Makehare/bell-aid/README.md

# bell-aid

Bell Aid

Release v1.3.1.

## Contents

- `docs/`
- `electronics/`
- `firmware/`
- `mechanics/`

## License

Hardware CERN-OHL-P-2.0, firmware MIT, documentation and renders CC-BY-4.0 (see LICENSE).
