Makehare/bell-aid/docs/renders/final/03-front.png

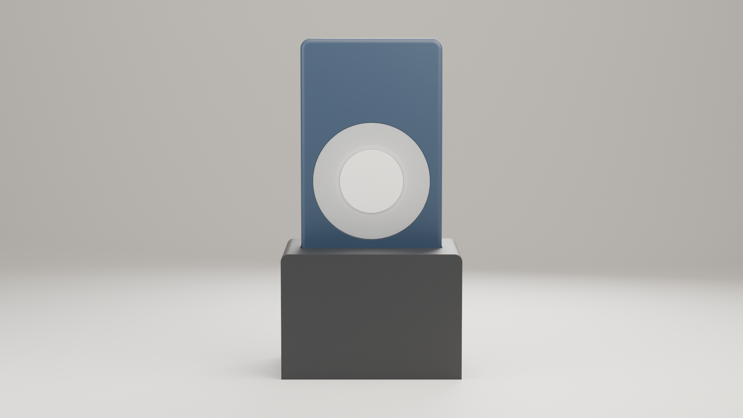
docs/renders/final/03-front.png
