Makehare/bell-aid/docs/renders/final/04-side-profile.png

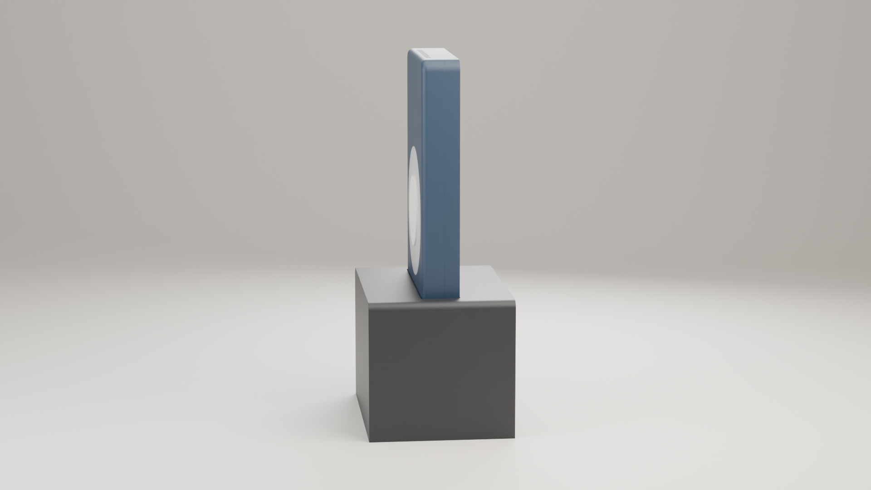
docs/renders/final/04-side-profile.png
