Makehare/bell-aid/electronics/dbn-main/fab/dbn-main.step

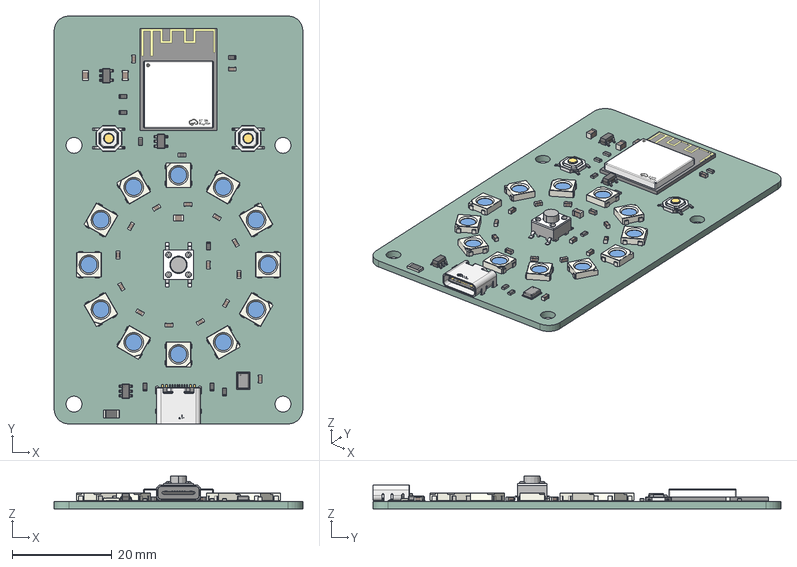
[picture p3: CAD file, 2026-11-07]
electronics/dbn-main/fab/dbn-main.step
50.0 x 82.0 x 6.59 mm
LED_WS2812B_PLCC4_50x50mm_P32mm x 12
KEY-SMD_4P-L6.0-W6.0-P4.50-LS9.5-BL
R_0603_1608Metric x 9
InvenSense_ICS-43434-6_3.5x2.65mm
SOT-23-6
C_0603_1608Metric x 17
USB-C_SMD-TYPE-C-31-M-12
SW-SMD_4P-L5.1-W5.1-P3.70-LS6.5-TL_H1.5 x 2
BULETM-SMD_ESP32-S3-MINI-1-N8
Fuse_1206_3216Metric
C_0805_2012Metric x 3
SOT-23-5 x 2
dbn-main_PCB
