Makehare/bell-aid/mechanics/ref/dbn-main_board_only.step

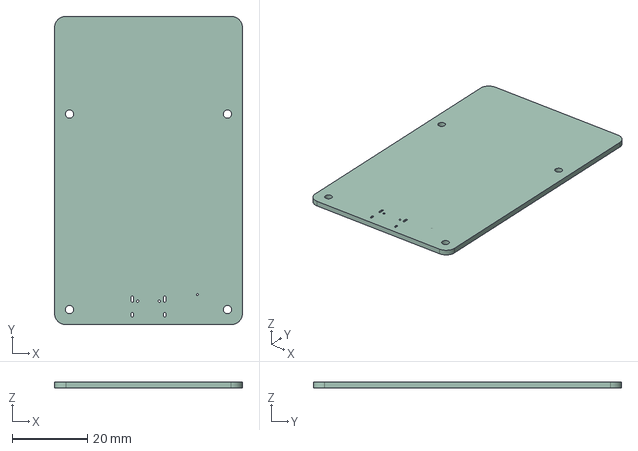
[picture p4: CAD file, 2026-11-02]
mechanics/ref/dbn-main_board_only.step
50.0 x 82.0 x 1.51 mm
