Makehare/bell-aid/mechanics/exports/parts/Plunger.step

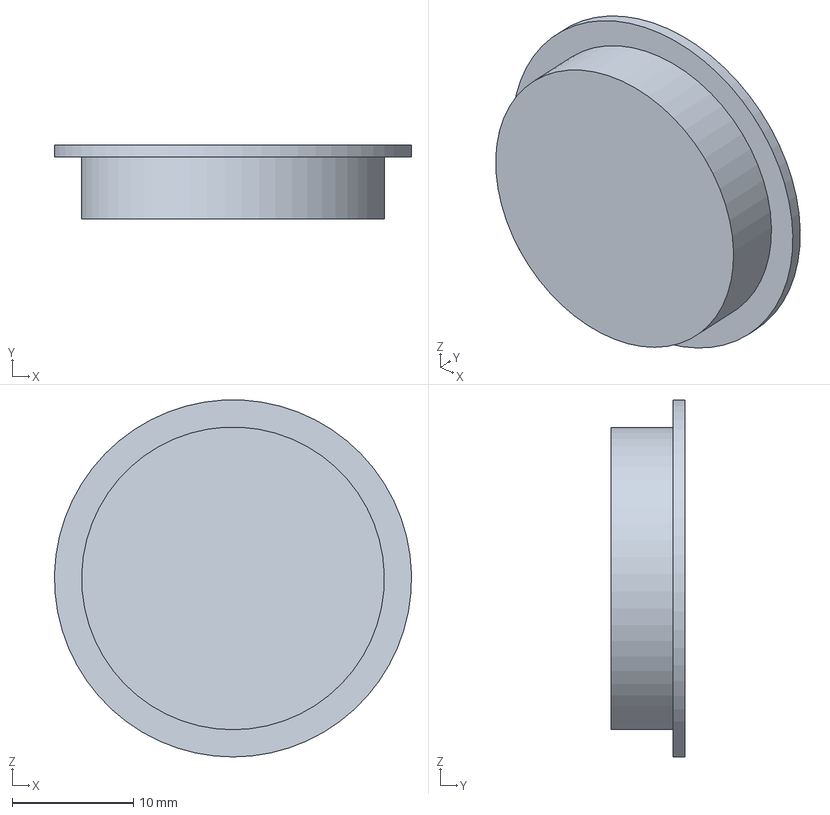
[picture p5: CAD file, 2026-11-02]
mechanics/exports/parts/Plunger.step
29.5 x 6.10 x 29.5 mm
