Makehare/bell-aid/mechanics/exports/parts/Case_back.step

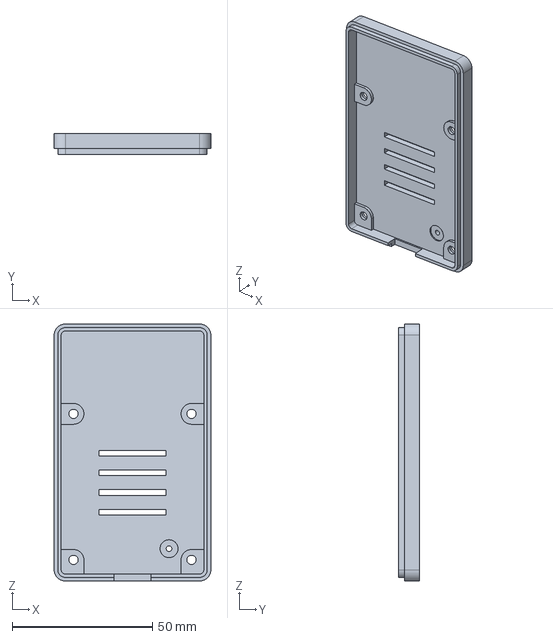
[picture p6: CAD file, 2026-11-02]
mechanics/exports/parts/Case_back.step
55.8 x 7.30 x 91.5 mm
