Makehare/bell-aid/mechanics/exports/doorbell-case_Diffuser.stl

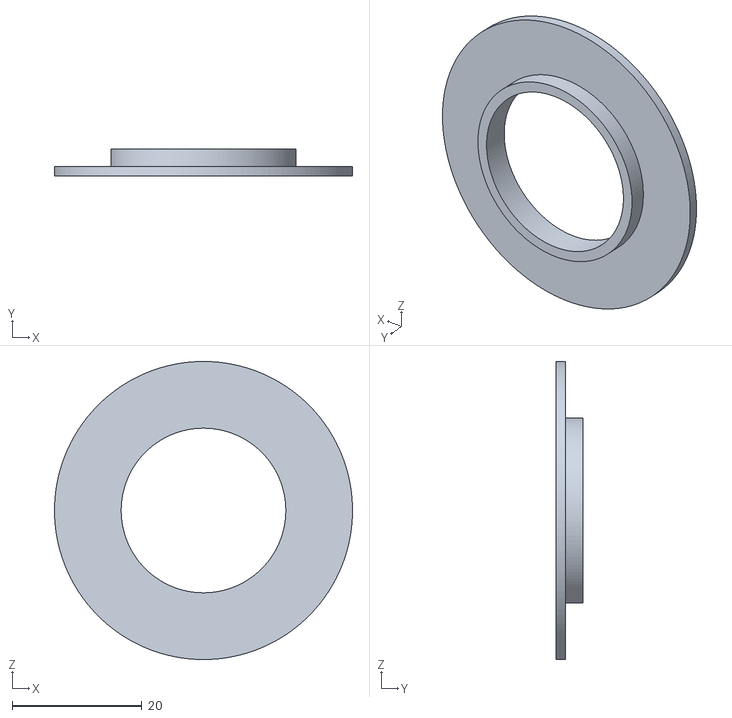
[picture p7: CAD file, 2026-11-02]
mechanics/exports/doorbell-case_Diffuser.stl
46.0 x 4.20 x 46.0
