Makehare/bell-aid/mechanics/exports/doorbell-case_Case_front.stl

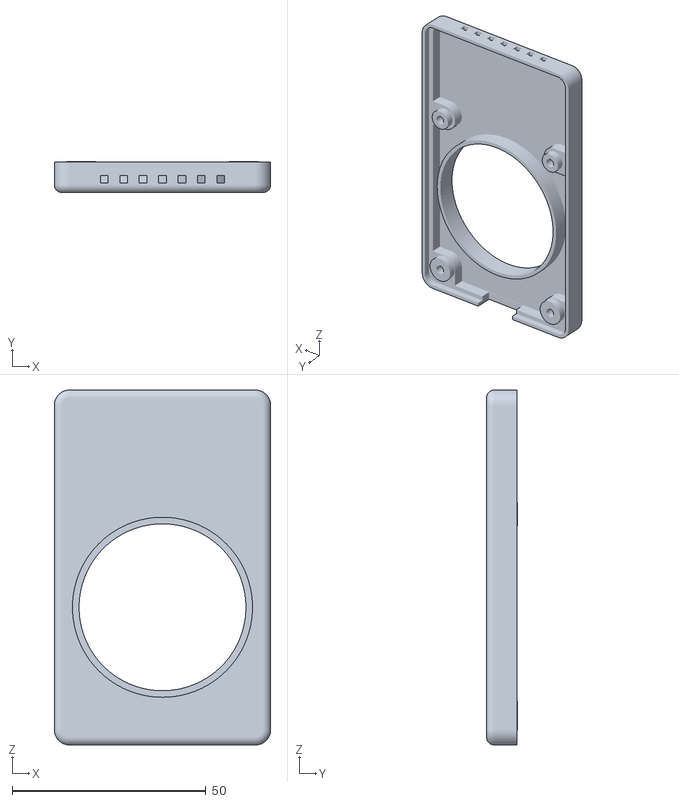
[picture p8: CAD file, 2026-11-02]
mechanics/exports/doorbell-case_Case_front.stl
55.8 x 7.99 x 91.5
