Makehare/bell-aid/mechanics/exports/doorbell-case_Plunger.stl

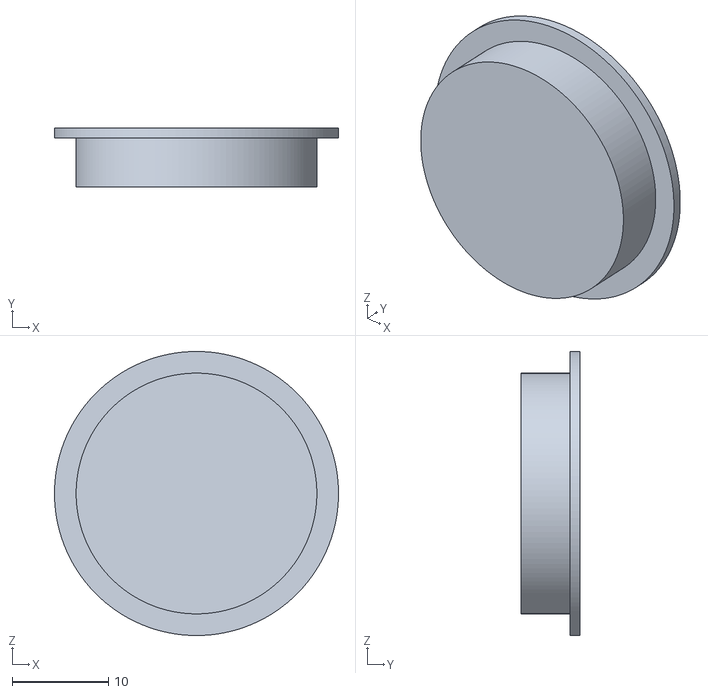
[picture p9: CAD file, 2026-11-02]
mechanics/exports/doorbell-case_Plunger.stl
29.5 x 6.10 x 29.5
