Makehare/bell-aid/mechanics/exports/doorbell-case_Foot.stl

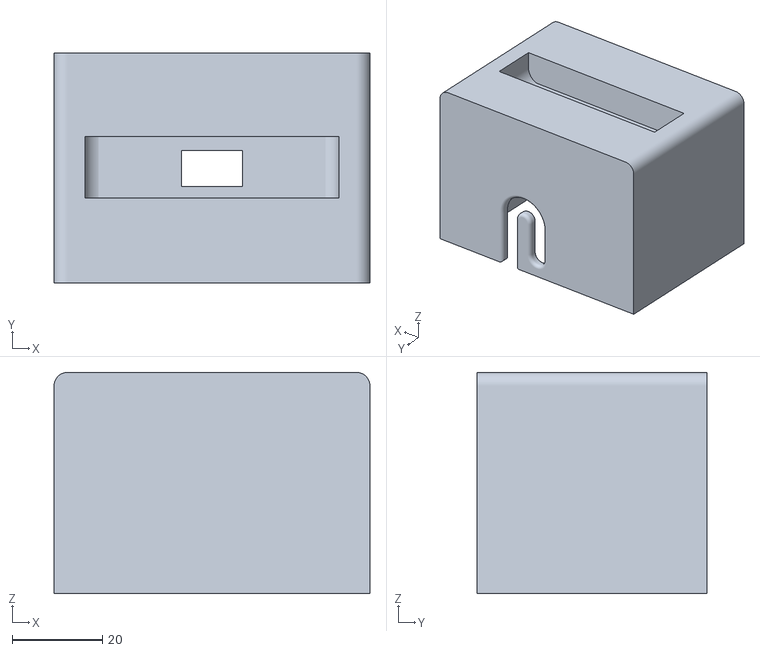
[picture p10: CAD file, 2026-11-02]
mechanics/exports/doorbell-case_Foot.stl
70.0 x 51.0 x 49.0
