Makehare/bell-aid/mechanics/exports/parts/Mic_gasket.step

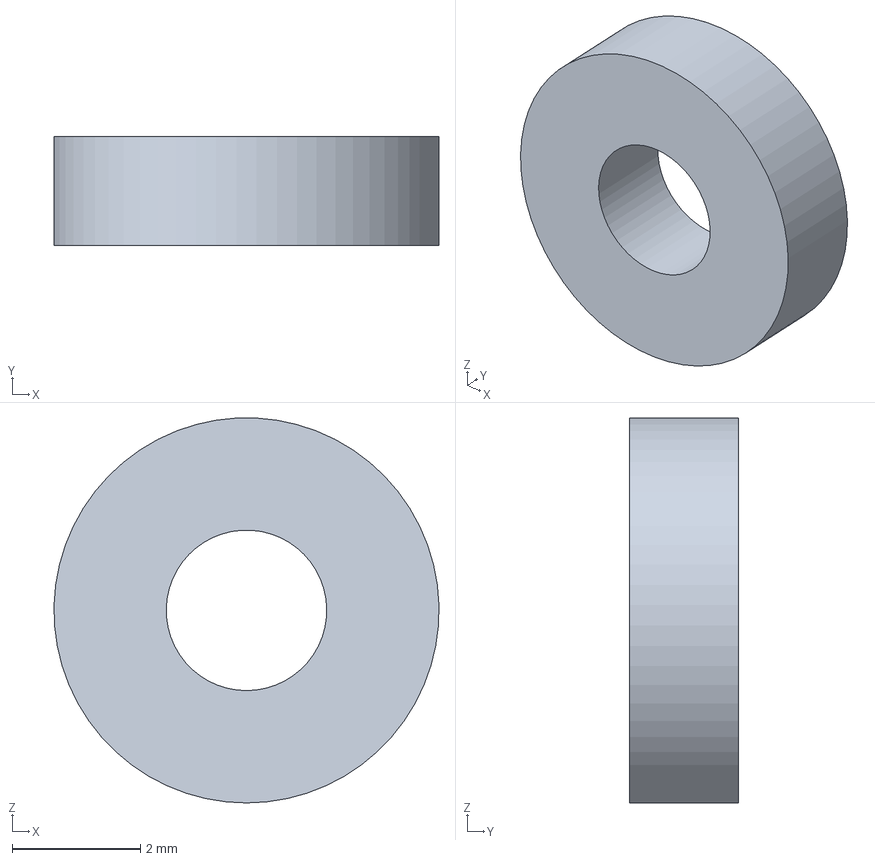
[picture p11: CAD file, 2026-11-02]
mechanics/exports/parts/Mic_gasket.step
6.00 x 1.70 x 6.00 mm
