Makehare/bell-aid/mechanics/exports/doorbell-case.step

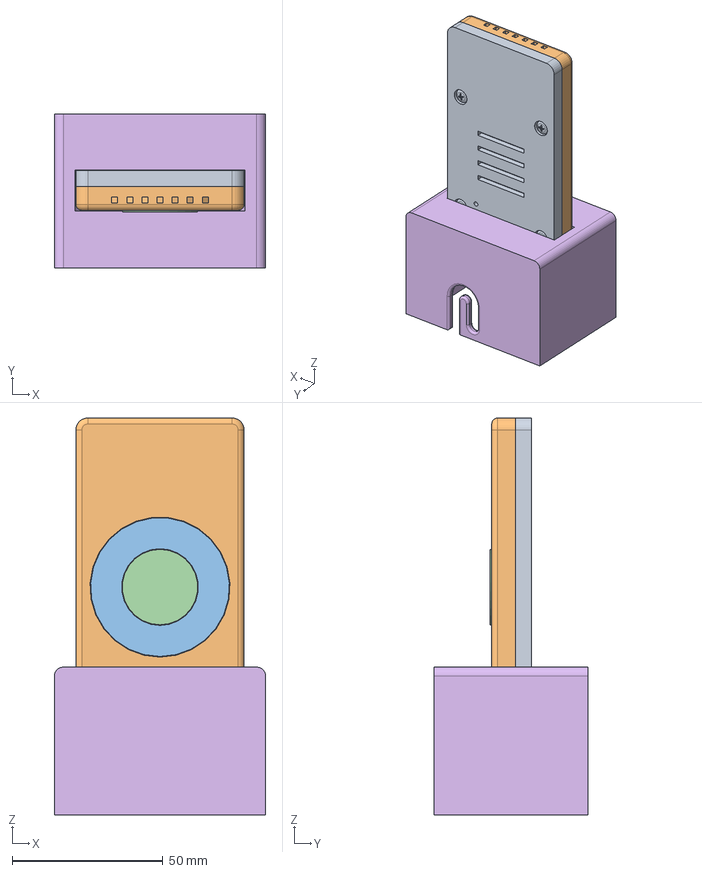
[picture p12: CAD file, 2026-11-02]
mechanics/exports/doorbell-case.step
70.0 x 51.0 x 131.5 mm
Case back
Case front
Diffuser
Plunger
Mic gasket
Foot
PCB DBN-MAIN
FAST_Screw M3x8 1
FAST_Screw M3x8 2
FAST_Screw M3x8 3
FAST_Screw M3x8 4
