Makehare/bell-aid/(list of files, cad)

Other CAD files:
electronics/dbn-main/fab/dbn-main_board_only.step
mechanics/ref/dbn-main.step
mechanics/exports/parts/PCB_DBN-MAIN.step
mechanics/exports/doorbell-case_PCB_DBN-MAIN.stl
mechanics/exports/parts/Diffuser.step
mechanics/exports/parts/Foot.step
mechanics/exports/doorbell-case_Case_back.stl
mechanics/exports/parts/Case_front.step
mechanics/exports/doorbell-case_Mic_gasket.stl
mechanics/doorbell-case.FCStd
mechanics/exports/doorbell-case.3mf
mechanics/exports/doorbell-case_FAST_Screw_M3x8_1.stl
mechanics/exports/doorbell-case_FAST_Screw_M3x8_2.stl
mechanics/exports/doorbell-case_FAST_Screw_M3x8_3.stl
mechanics/exports/doorbell-case_FAST_Screw_M3x8_4.stl
mechanics/exports/parts/FAST_Screw_M3x8_1.step
mechanics/exports/parts/FAST_Screw_M3x8_2.step
mechanics/exports/parts/FAST_Screw_M3x8_3.step
mechanics/exports/parts/FAST_Screw_M3x8_4.step
