Makehare/bell-aid/electronics/dbn-main/dbn-main.kicad_pcb

## KiCad design electronics/dbn-main/dbn-main.kicad_pcb (2026-11-07)

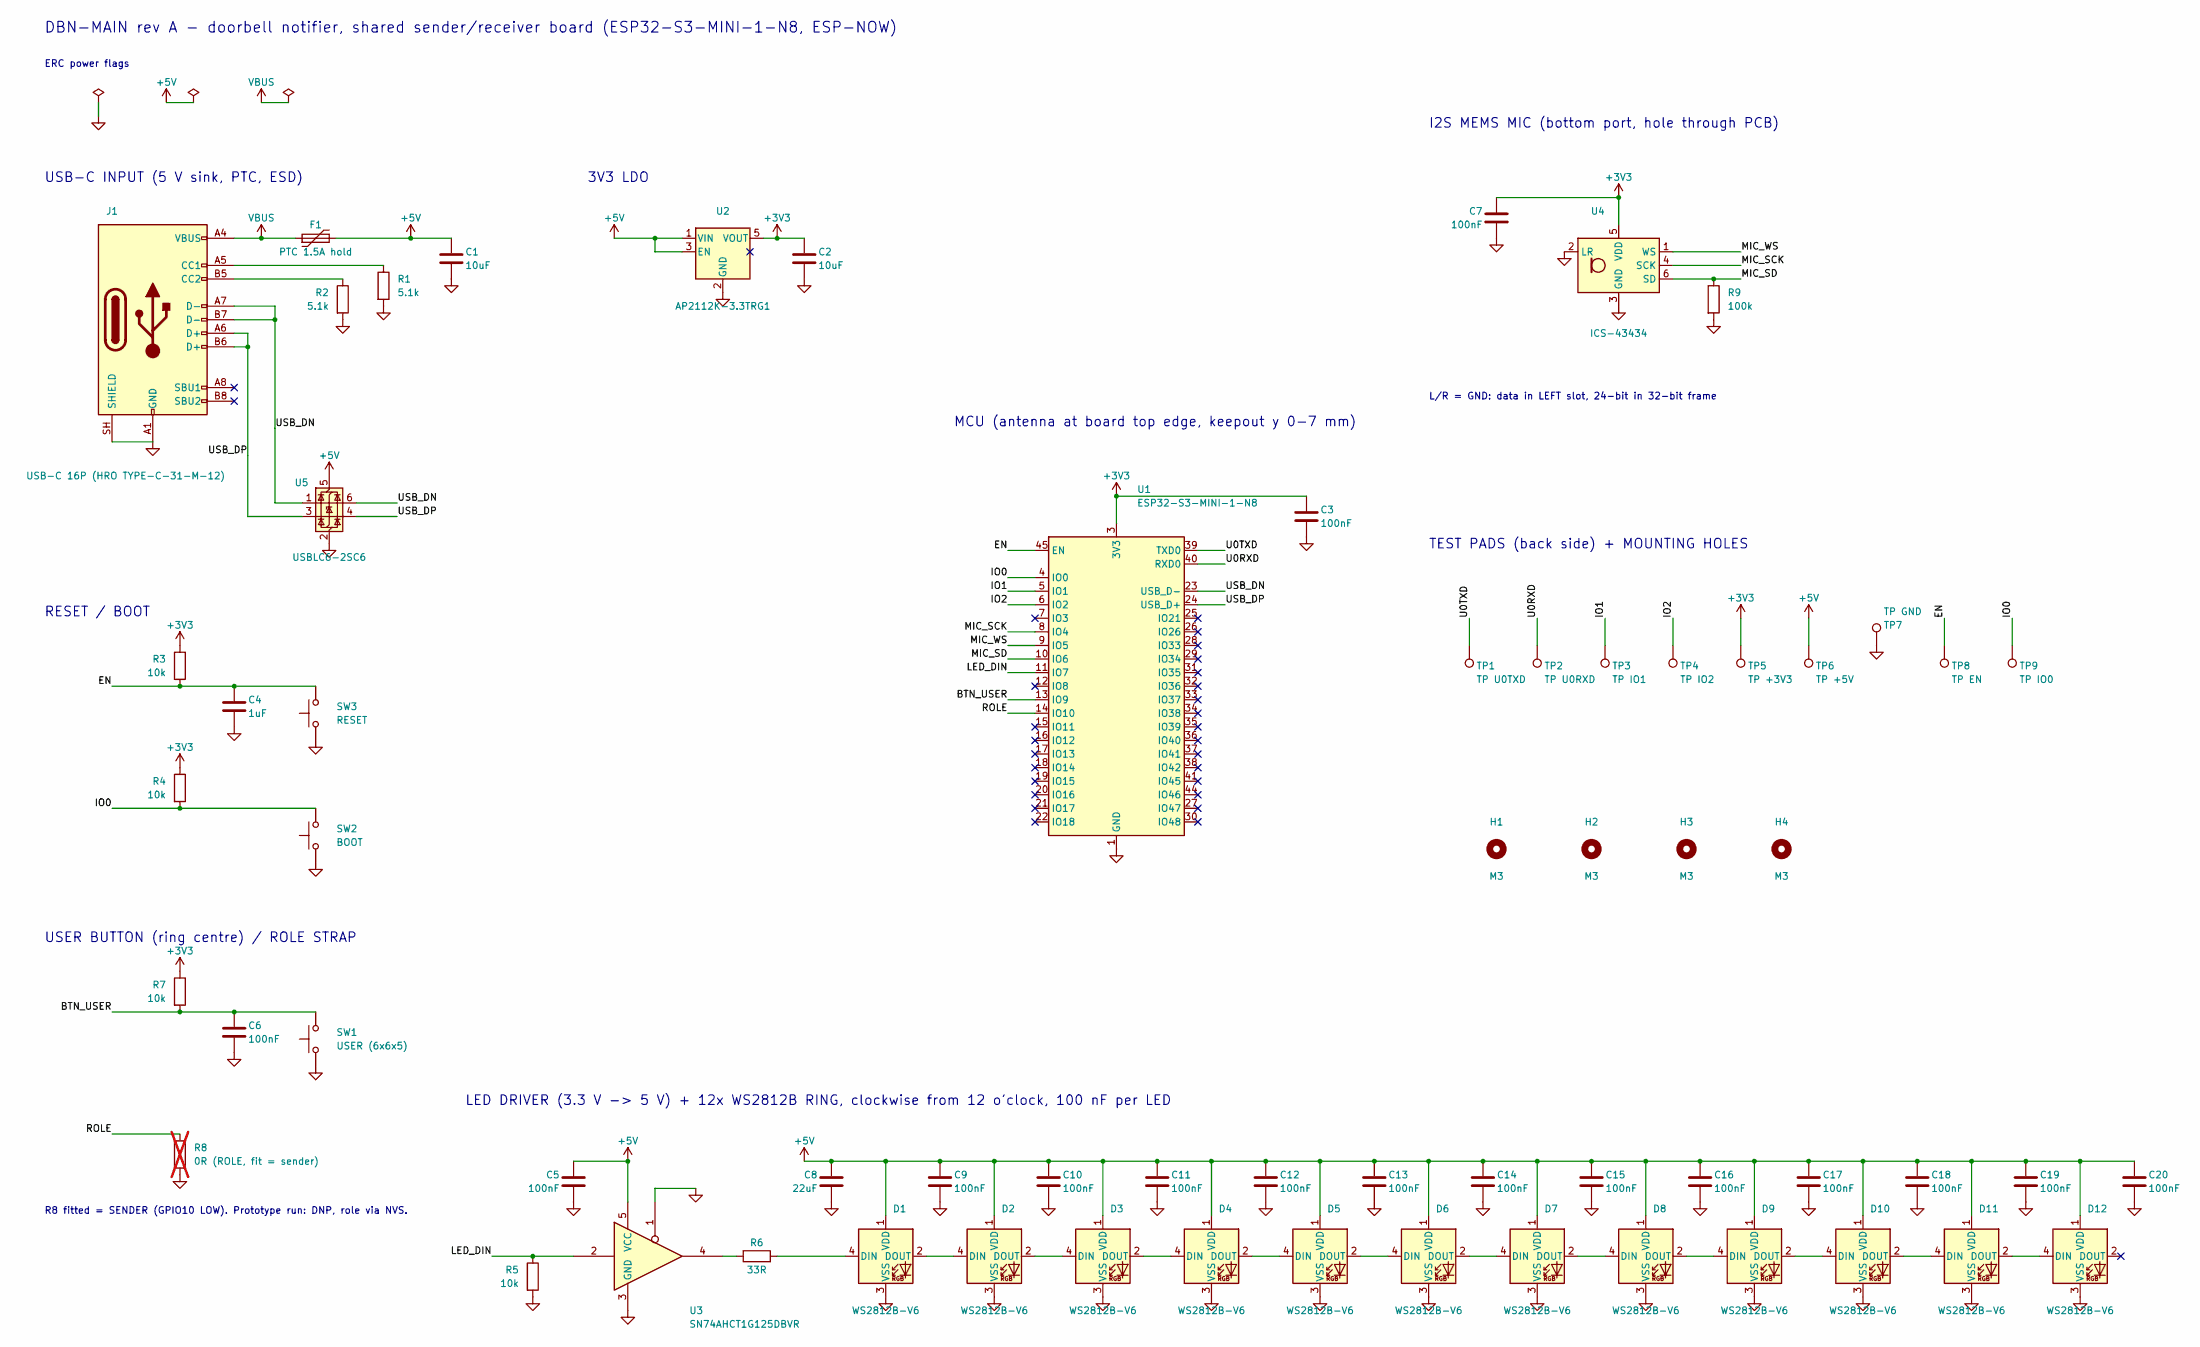
[picture p21: schematic dbn-main.kicad_sch, DBN-MAIN doorbell notifier (sender/receiver)]

Parts:
C1, C2: 10uF; C_0805_2012Metric; MPN CL21A106KAYNNNE; LCSC C15850
C3, C5, C6, C7, C9, C10, C11, C12, C13, C14, C15, C16, C17, C18, C19, C20: 100nF; C_0603_1608Metric; MPN CC0603KRX7R9BB104; LCSC C14663
C4: 1uF; C_0603_1608Metric; MPN CL10A105KB8NNNC; LCSC C15849
C8: 22uF; C_0805_2012Metric; MPN CL21A226MAQNNNE; LCSC C45783
D1, D2, D3, D4, D5, D6, D7, D8, D9, D10, D11, D12: WS2812B-V6; LED_WS2812B_PLCC4_5.0x5.0mm_P3.2mm; MPN WS2812B-V6; LCSC C52917433
F1: PTC 1.5A hold; Fuse_1206_3216Metric; MPN 1206L150THWR; LCSC C118413
H1, H2, H3, H4: M3; MountingHole_3.2mm_M3_NPTH
J1: USB-C 16P (HRO TYPE-C-31-M-12); USB_C_Receptacle_HRO_TYPE-C-31-M-12; MPN TYPE-C-31-M-12; LCSC C165948
R1, R2: 5.1k; R_0603_1608Metric; MPN 0603WAF5101T5E; LCSC C23186
R3, R4, R5, R7: 10k; R_0603_1608Metric; MPN 0603WAF1002T5E; LCSC C25804
R6: 33R; R_0603_1608Metric; MPN 0603WAF330JT5E; LCSC C23140
R8: 0R (ROLE, fit = sender); R_0603_1608Metric; MPN 0603WAF0000T5E; LCSC C21189; not fitted
R9: 100k; R_0603_1608Metric; MPN 0603WAF1003T5E; LCSC C25803
SW1: USER (6x6x5); SW_K2-1102SP-C4SC-04_6x6x5mm; MPN K2-1102SP-C4SC-04; LCSC C127509
SW2: BOOT; SW_Push_1P1T_XKB_TS-1187A; MPN TS-1187A-B-A-B; LCSC C318884
SW3: RESET; SW_Push_1P1T_XKB_TS-1187A; MPN TS-1187A-B-A-B; LCSC C318884
TP1: TP U0TXD; TestPoint_Pad_D1.5mm
TP2: TP U0RXD; TestPoint_Pad_D1.5mm
TP3: TP IO1; TestPoint_Pad_D1.5mm
TP4: TP IO2; TestPoint_Pad_D1.5mm
TP5: TP +3V3; TestPoint_Pad_D1.5mm
TP6: TP +5V; TestPoint_Pad_D1.5mm
TP7: TP GND; TestPoint_Pad_D1.5mm
TP8: TP EN; TestPoint_Pad_D1.5mm
TP9: TP IO0; TestPoint_Pad_D1.5mm
U1: ESP32-S3-MINI-1-N8; ESP32-S3-MINI-1; MPN ESP32-S3-MINI-1-N8; LCSC C2913206
U2: AP2112K-3.3TRG1; SOT-23-5; MPN AP2112K-3.3TRG1; LCSC C51118
U3: SN74AHCT1G125DBVR; SOT-23-5; MPN SN74AHCT1G125DBVR; LCSC C7484
U4: ICS-43434; InvenSense_ICS-43434-6_3.5x2.65mm; MPN ICS-43434; LCSC C5656610
U5: USBLC6-2SC6; SOT-23-6; MPN USBLC6-2SC6; LCSC C7519

Connections:
+3V3: C2.1, C3.1, C7.1, R3.1, R4.1, R7.1, TP5.1, U1.3 (3V3), U2.5 (VOUT), U4.5 (VDD)
+5V: C1.1, C5.1, C8.1, C9.1, C10.1, C11.1, C12.1, C13.1, C14.1, C15.1, C16.1, C17.1, C18.1, C19.1, C20.1, D1.1 (VDD), D2.1 (VDD), D3.1 (VDD), D4.1 (VDD), D5.1 (VDD), D6.1 (VDD), D7.1 (VDD), D8.1 (VDD), D9.1 (VDD), D10.1 (VDD), D11.1 (VDD), D12.1 (VDD), F1.2, TP6.1, U2.1 (VIN), U2.3 (EN), U3.5 (VCC), U5.5 (VBUS)
/BTN_USER: C6.1, R7.2, SW1.2, U1.13 (IO9)
/EN: C4.1, R3.2, SW3.2, TP8.1, U1.45 (EN)
/IO0: R4.2, SW2.2, TP9.1, U1.4 (IO0)
/IO1: TP3.1, U1.5 (IO1)
/IO2: TP4.1, U1.6 (IO2)
/LED_DIN: R5.1, U1.11 (IO7), U3.2
/MIC_SCK: U1.8 (IO4), U4.4 (SCK)
/MIC_SD: R9.1, U1.10 (IO6), U4.6 (SD)
/MIC_WS: U1.9 (IO5), U4.1 (WS)
/ROLE: R8.1, U1.14 (IO10)
/U0RXD: TP2.1, U1.40 (RXD0)
/U0TXD: TP1.1, U1.39 (TXD0)
/USB_DN: J1.A7 (D-), J1.B7 (D-), U1.23 (USB_D-), U5.1 (I/O1), U5.6 (I/O1)
/USB_DP: J1.A6 (D+), J1.B6 (D+), U1.24 (USB_D+), U5.3 (I/O2), U5.4 (I/O2)
GND: C1.2, C2.2, C3.2, C4.2, C5.2, C6.2, C7.2, C8.2, C9.2, C10.2, C11.2, C12.2, C13.2, C14.2, C15.2, C16.2, C17.2, C18.2, C19.2, C20.2, D1.3 (VSS), D2.3 (VSS), D3.3 (VSS), D4.3 (VSS), D5.3 (VSS), D6.3 (VSS), D7.3 (VSS), D8.3 (VSS), D9.3 (VSS), D10.3 (VSS), D11.3 (VSS), D12.3 (VSS), J1.A1 (GND), J1.A12 (GND), J1.B1 (GND), J1.B12 (GND), J1.SH (SHIELD), R1.2, R2.2, R5.2, R8.2, R9.2, SW1.1, SW2.1, SW3.1, TP7.1, U1.1 (GND), U1.2 (GND), U1.42 (GND), U1.43 (GND), U1.46 (GND), U1.47 (GND), U1.48 (GND), U1.49 (GND), U1.50 (GND), U1.51 (GND), U1.52 (GND), U1.53 (GND), U1.54 (GND), U1.55 (GND), U1.56 (GND), U1.57 (GND), U1.58 (GND), U1.59 (GND), U1.60 (GND), U1.61 (GND), U1.62 (GND), U1.63 (GND), U1.64 (GND), U1.65 (GND), U2.2 (GND), U3.1, U3.3 (GND), U4.2 (LR), U4.3 (GND), U5.2 (GND)
unnamed: D1.4 (DIN), R6.2
unnamed: D1.2 (DOUT), D2.4 (DIN)
unnamed: D2.2 (DOUT), D3.4 (DIN)
unnamed: D3.2 (DOUT), D4.4 (DIN)
unnamed: D4.2 (DOUT), D5.4 (DIN)
unnamed: D5.2 (DOUT), D6.4 (DIN)
unnamed: D6.2 (DOUT), D7.4 (DIN)
unnamed: D7.2 (DOUT), D8.4 (DIN)
unnamed: D8.2 (DOUT), D9.4 (DIN)
unnamed: D9.2 (DOUT), D10.4 (DIN)
unnamed: D10.2 (DOUT), D11.4 (DIN)
unnamed: D11.2 (DOUT), D12.4 (DIN)
unnamed: J1.A5 (CC1), R1.1
unnamed: J1.B5 (CC2), R2.1
unnamed: R6.1, U3.4
VBUS: F1.1, J1.A4 (VBUS), J1.A9 (VBUS), J1.B4 (VBUS), J1.B9 (VBUS)

Notes on the sheet:
DBN-MAIN rev A - doorbell notifier, shared sender/receiver board (ESP32-S3-MINI-1-N8, ESP-NOW)
ERC power flags
USB-C INPUT (5 V sink, PTC, ESD)
3V3 LDO
MCU (antenna at board top edge, keepout y 0-7 mm)
RESET / BOOT
USER BUTTON (ring centre) / ROLE STRAP
R8 fitted = SENDER (GPIO10 LOW). Prototype run: DNP, role via NVS.
I2S MEMS MIC (bottom port, hole through PCB)
L/R = GND: data in LEFT slot, 24-bit in 32-bit frame
LED DRIVER (3.3 V -> 5 V) + 12x WS2812B RING, clockwise from 12 o'clock, 100 nF per LED
TEST PADS (back side) + MOUNTING HOLES

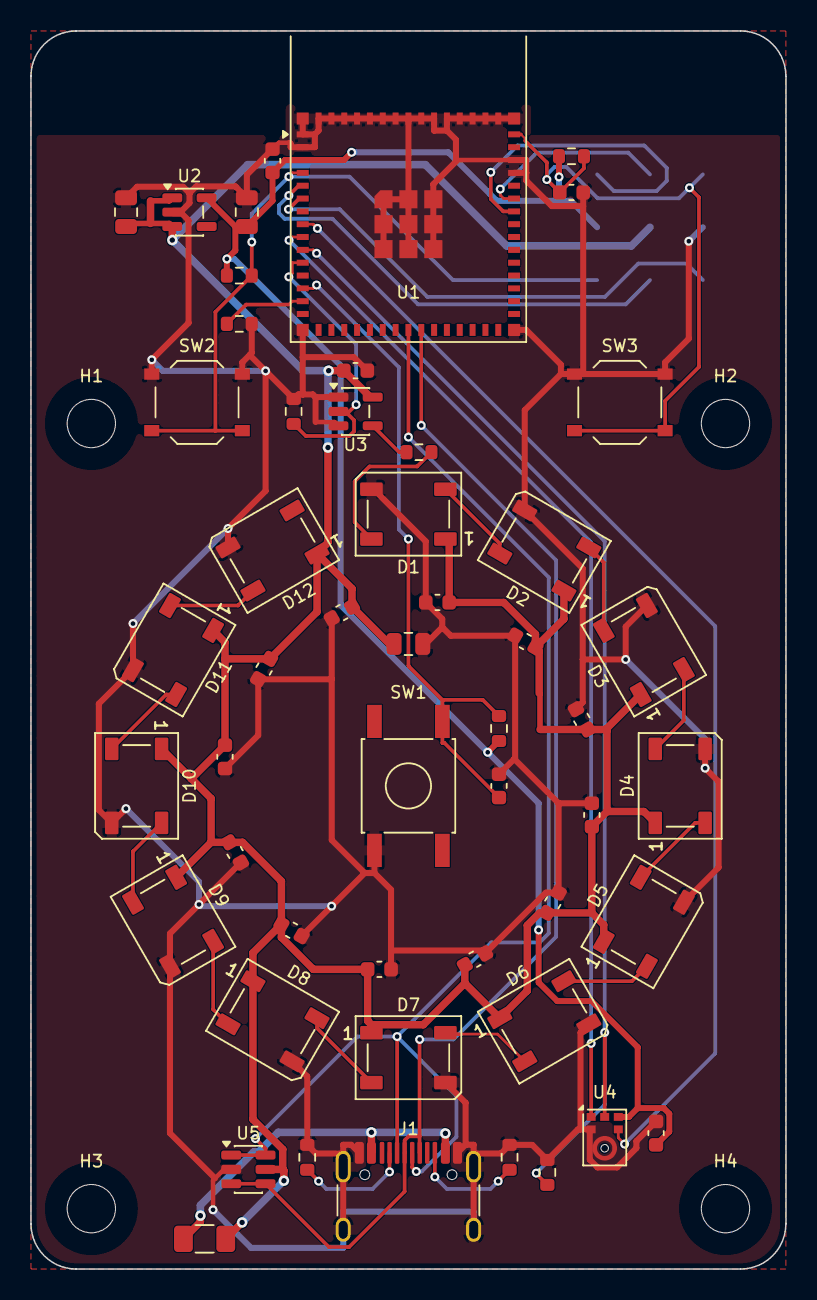
[picture p22: board dbn-main.kicad_pcb from above]

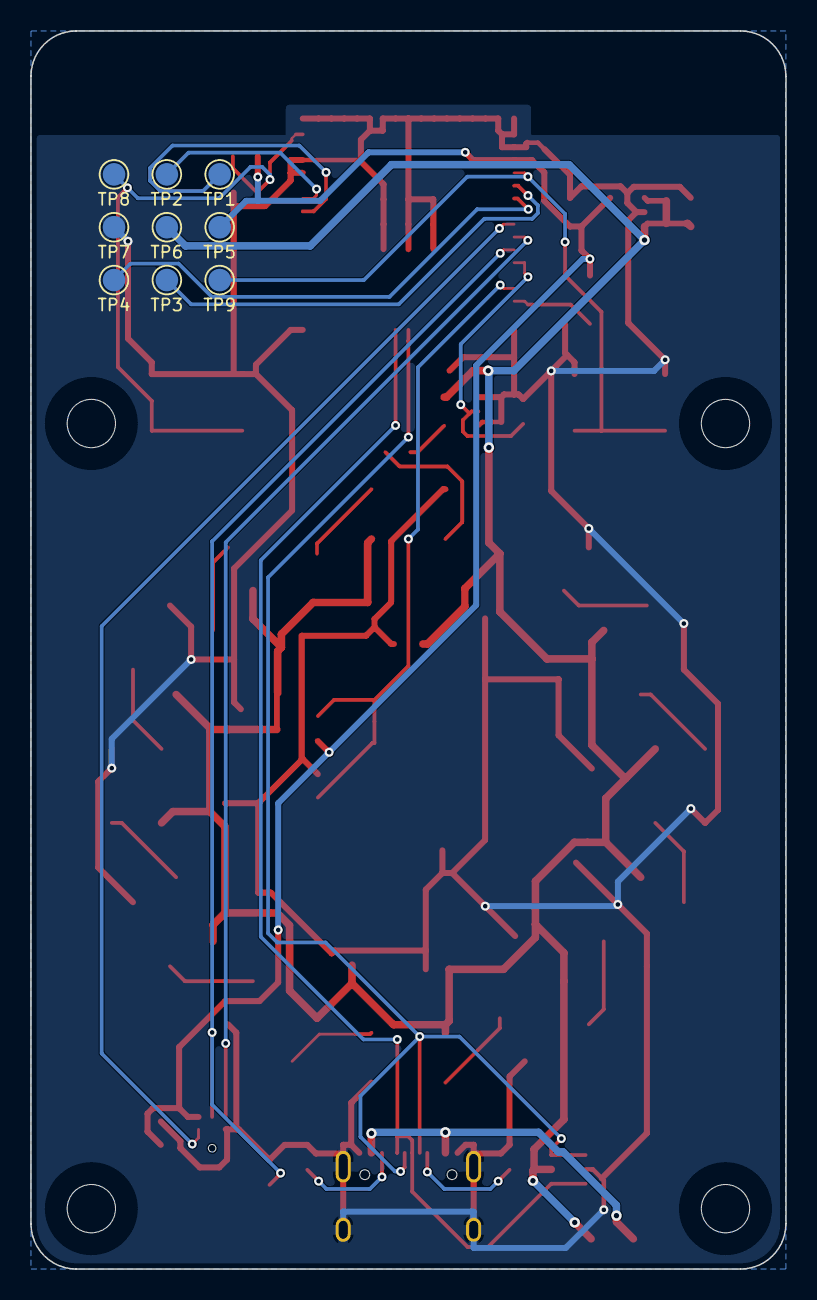
[picture p23: board dbn-main.kicad_pcb from below]

Board: 2 copper layers, 50.0 x 82.0 mm, 64 parts (9 on the bottom side), 33 nets.
