Makehare/bell-aid/(commit log)

2026-11-02 Release v1.0
    [Case_back.step, Case_front.step, Diffuser.step, FAST_Screw_M3x8_1.step, FAST_Screw_M3x8_2.step, FAST_Screw_M3x8_3.step, FAST_Screw_M3x8_4.step, Foot.step]
2026-11-07 Release v1.2
    [dbn-main.kicad_pcb, dbn-main.kicad_sch, dbn-main.step, dbn-main_board_only.step]
